SonK16-UIT/Fall-Detection-System-and-Location-Awareness/Images/falling.png

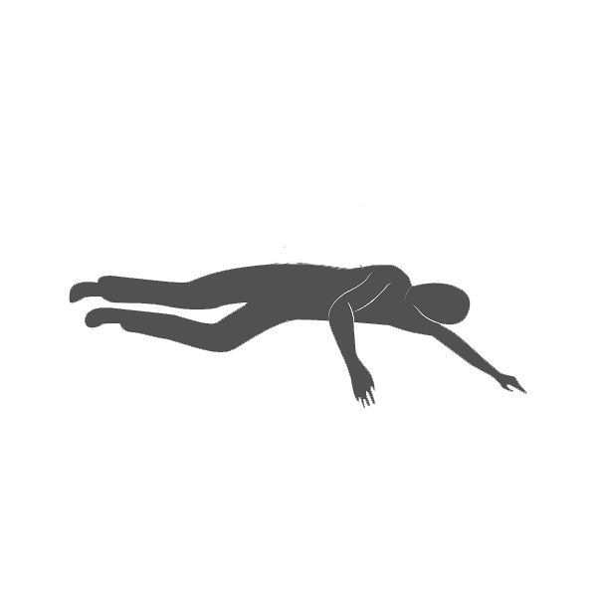
Images/falling.png
