SonK16-UIT/Fall-Detection-System-and-Location-Awareness/Images/light.png

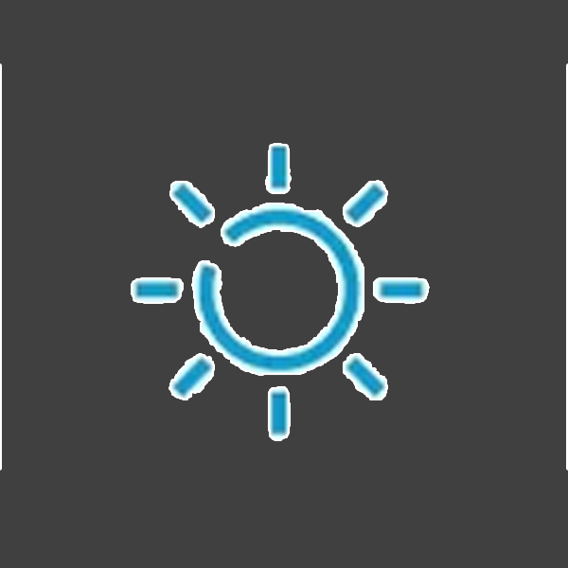
Images/light.png
