SonK16-UIT/Fall-Detection-System-and-Location-Awareness/Images/moisture.png

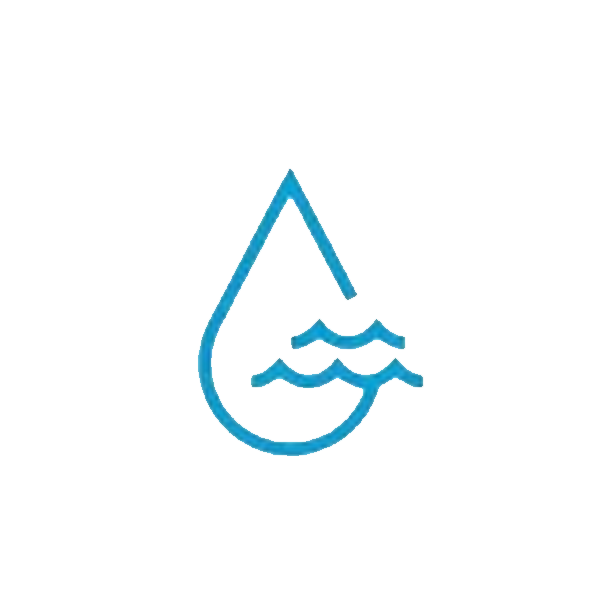
Images/moisture.png
