SonK16-UIT/Fall-Detection-System-and-Location-Awareness/Images/MOTION.png

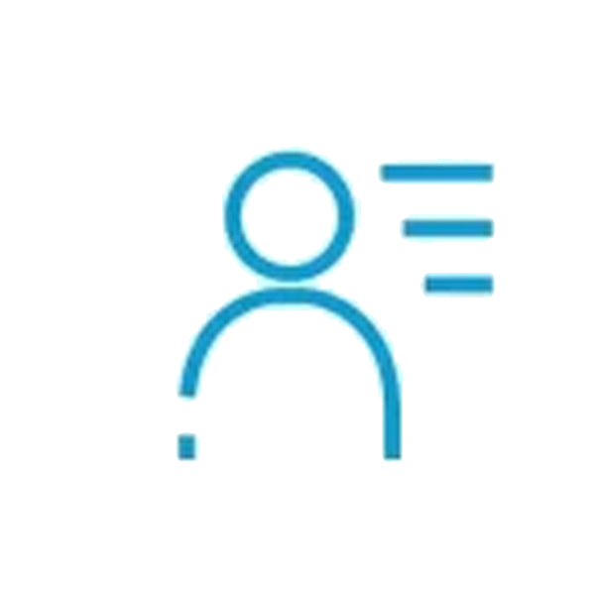
Images/MOTION.png
