SonK16-UIT/Fall-Detection-System-and-Location-Awareness/Images/Temp.png

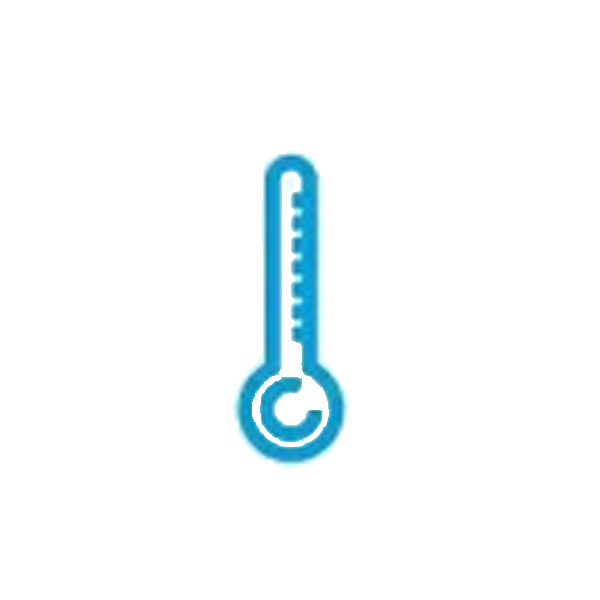
Images/Temp.png
