SonK16-UIT/Fall-Detection-System-and-Location-Awareness/Images/unnamed.webp

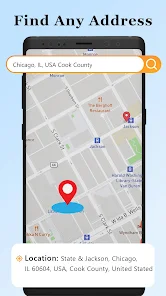
Images/unnamed.webp
