SonK16-UIT/Fall-Detection-System-and-Location-Awareness/Images/wifi.png

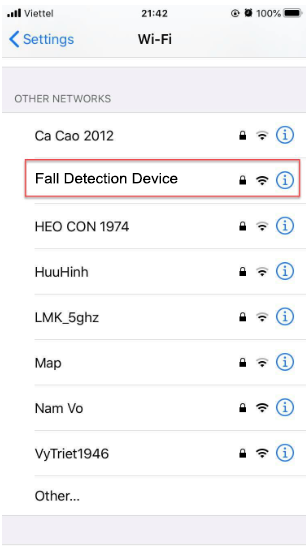
Images/wifi.png
