SonK16-UIT/Fall-Detection-System-and-Location-Awareness/Images/z4870815044626_4b06ed644bb9f73c9bcfcfed8d9568f1.jpg

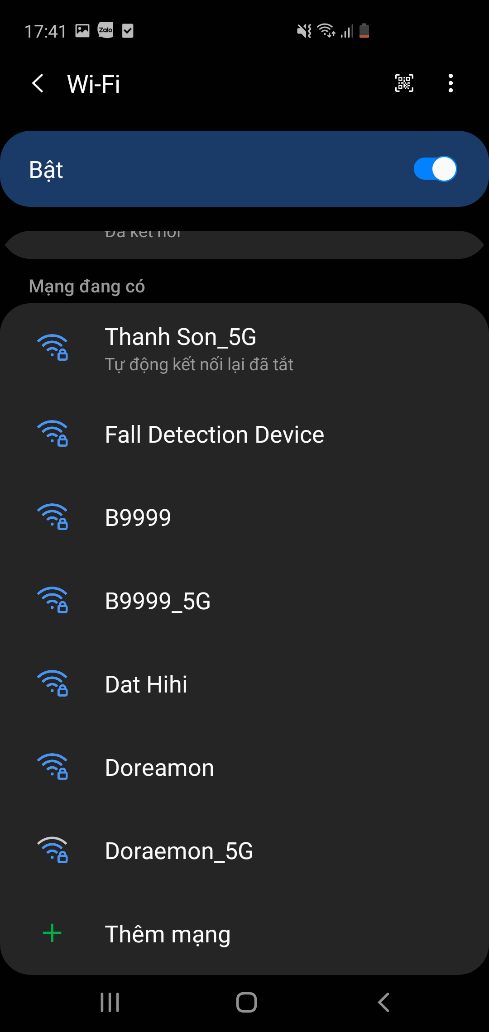
Images/z4870815044626_4b06ed644bb9f73c9bcfcfed8d9568f1.jpg
