SonK16-UIT/Fall-Detection-System-and-Location-Awareness/Images/z4870815596399_9f61c1c58ac517a5e50acf0c27d841eb.jpg

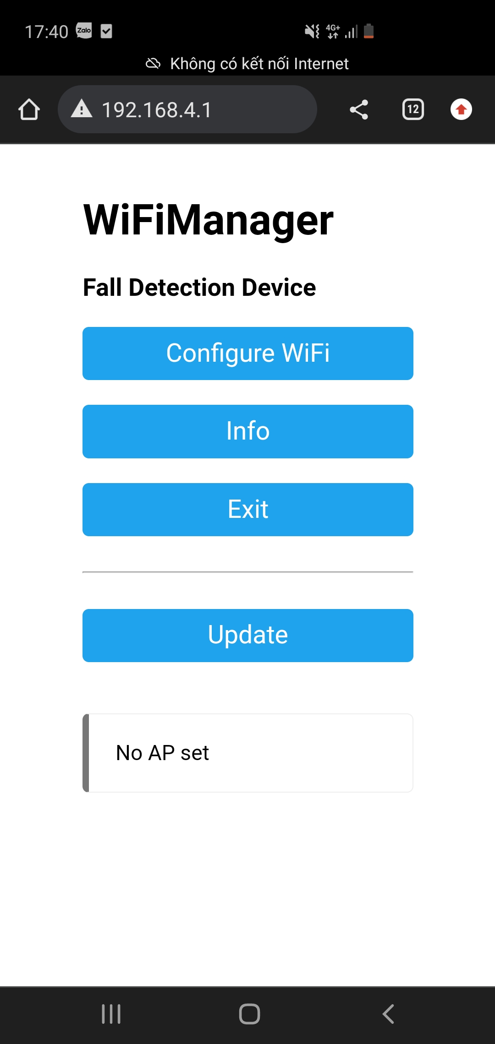
Images/z4870815596399_9f61c1c58ac517a5e50acf0c27d841eb.jpg
