SonK16-UIT/Fall-Detection-System-and-Location-Awareness/Images/z4870922454559_56d6ed83c932aedab3f11a8c38f706d6.jpg

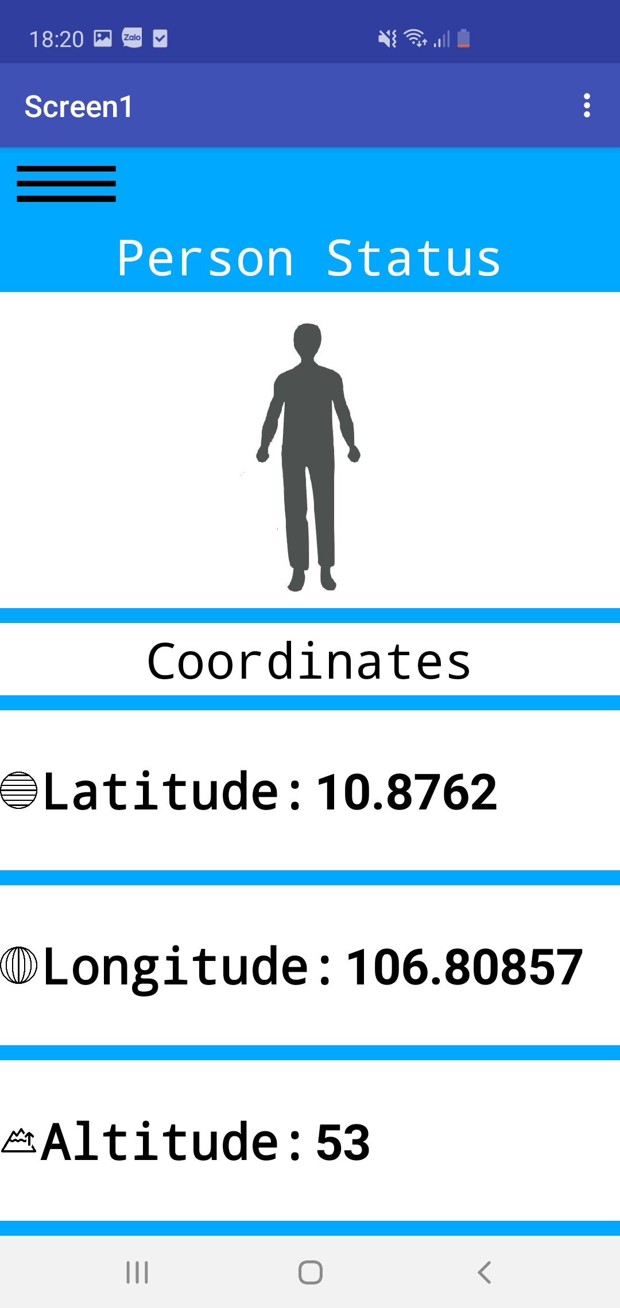
Images/z4870922454559_56d6ed83c932aedab3f11a8c38f706d6.jpg
