SonK16-UIT/Fall-Detection-System-and-Location-Awareness/Images/z4870922462679_fc5e134bdc8d8369d75c3672fc938026.jpg

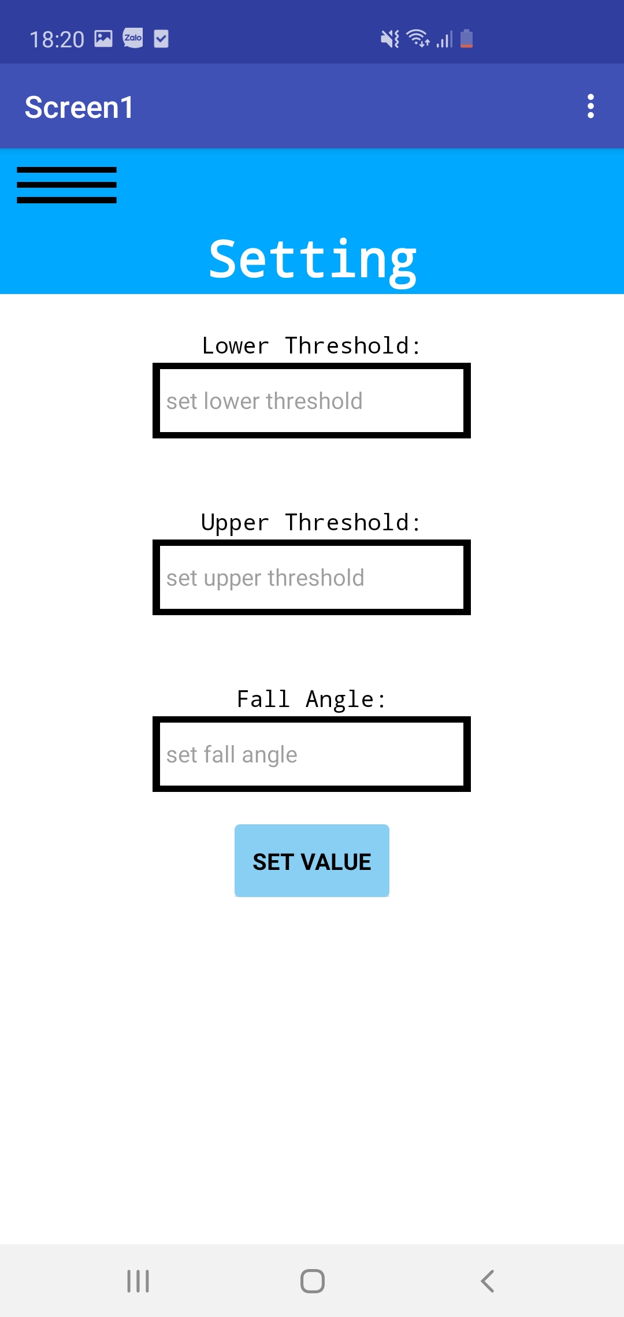
Images/z4870922462679_fc5e134bdc8d8369d75c3672fc938026.jpg
