SonK16-UIT/Fall-Detection-System-and-Location-Awareness/Images/z4870922466863_de2005718b119eab042fb2b8bee20431.jpg

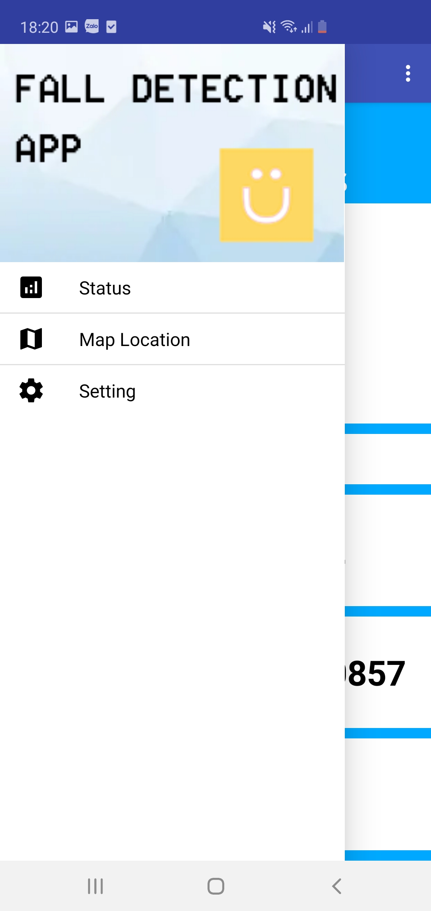
Images/z4870922466863_de2005718b119eab042fb2b8bee20431.jpg
