SonK16-UIT/Fall-Detection-System-and-Location-Awareness/Data from Testing/Fall Scenarios_Graph.xlsx

Fall forward | Fall backward | Fall to the left | Fall to the right | Fall forward | Fall backward | Fall to the left | Fall to the right
138.14 | 46.17 | 75.63 | 117.79 | 90.42 | 70.14 | 70.89 | 57.71
135.59 | 54.99 | 73.34 | 119.96 | 89.94 | 70.07 | 70.72 | 57.68
132.05 | 66.99 | 70.93 | 121 | 89.41 | 69.98 | 70.55 | 57.66
130.52 | 73.67 | 67.65 | 121.57 | 88.87 | 69.89 | 70.37 | 57.64
129.53 | 78.84 | 66.23 | 121.74 | 88.29 | 69.77 | 70.19 | 57.63
129.55 | 82.59 | 65.77 | 121.51 | 87.68 | 69.65 | 70.01 | 57.62
131.02 | 86.57 | 66.62 | 120.51 | 87.02 | 69.51 | 69.82 | 57.62
133.28 | 88.2 | 70.74 | 119.39 | 86.33 | 69.37 | 69.62 | 57.63
137.67 | 88.8 | 75.6 | 116.96 | 85.57 | 69.22 | 69.42 | 57.65
141.1 | 88 | 81.93 | 115.17 | 84.76 | 69.07 | 69.21 | 57.67
146.63 | 83.7 | 93.8 | 111.97 | 83.92 | 68.92 | 68.99 | 57.69
150.31 | 79.49 | 103.1 | 109.63 | 83.07 | 68.79 | 68.76 | 57.71
155.2 | 75.15 | 113.38 | 106.29 | 82.23 | 68.65 | 68.52 | 57.74
164.6 | 69.9 | 129.81 | 104.15 | 81.49 | 68.53 | 68.26 | 57.77
172.43 | 67.52 | 141.05 | 102.16 | 81 | 68.42 | 67.98 | 57.8
188.3 | 65.78 | 158.34 | 99.55 | 80.59 | 68.33 | 67.67 | 57.83
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
