SonK16-UIT/Fall-Detection-System-and-Location-Awareness/(commit log)

2023-11-22 Add Embedded System Project
    [ADL scenarios.xlsx, Fall scenarios.xlsx]
2024-10-06 format files
    [ADL Scenarios_Graph.xlsx, Fall Scenarios_Graph.xlsx]
